shreyala/453-Locker-Project/print files/description.txt

A folder containing all the 3D printed parts for the locker.
