shreyala/453-Locker-Project/cad-drawings/description.txt

This folder contains all the CAD drawings our team used in the implementation of the project.
