shreyala/453-Locker-Project/stl/bottomhousing.stl

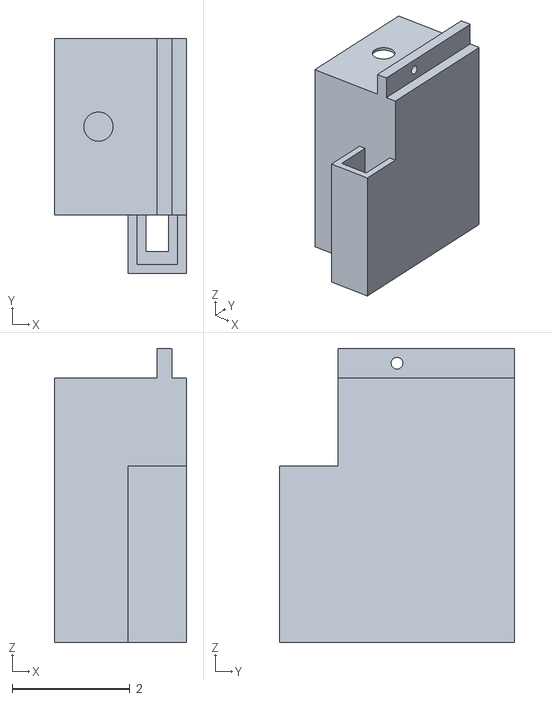
[picture p27: CAD file, 2021-05-12]
stl/bottomhousing.stl
2.25 x 4.00 x 5.00
