shreyala/453-Locker-Project/stl/tophousing.stl

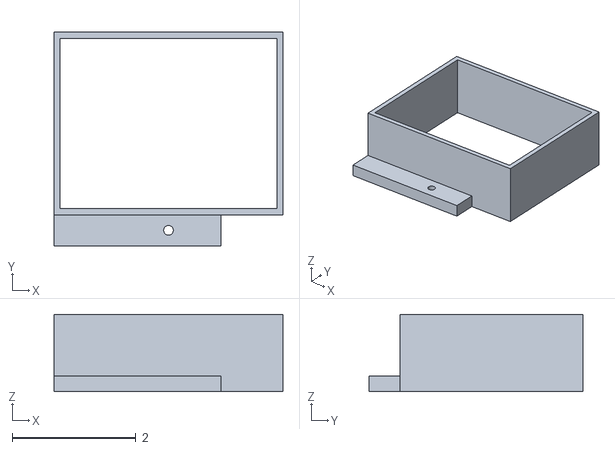
[picture p28: CAD file, 2021-05-12]
stl/tophousing.stl
3.70 x 3.45 x 1.25
