shreyala/453-Locker-Project/stl/insert3DHandle.stl

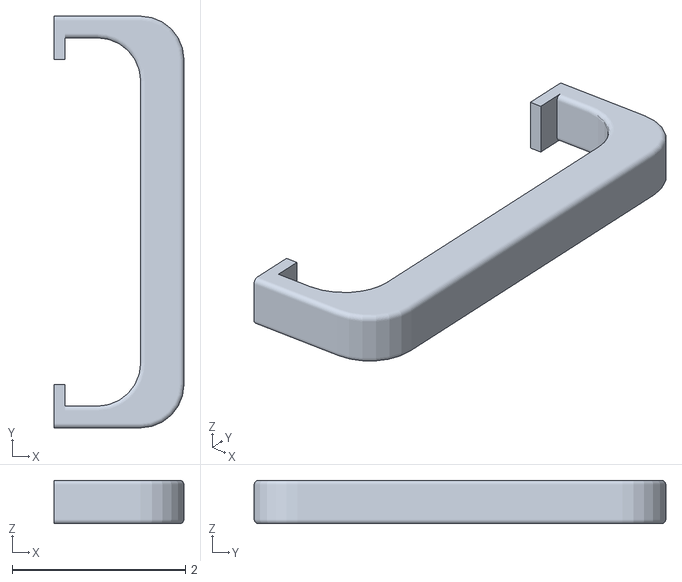
[picture p29: CAD file, 2021-05-12]
stl/insert3DHandle.stl
1.50 x 4.75 x 0.5
