shreyala/453-Locker-Project/stl/insert3DwithHandlecutout.stl

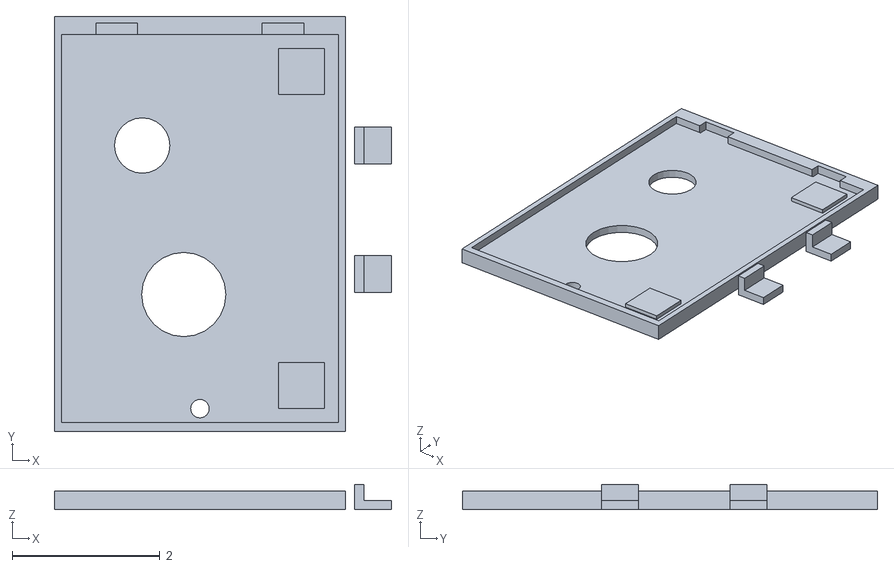
[picture p30: CAD file, 2021-05-12]
stl/insert3DwithHandlecutout.stl
4.56 x 5.62 x 0.344
