shreyala/453-Locker-Project/stl/L_mount.stl

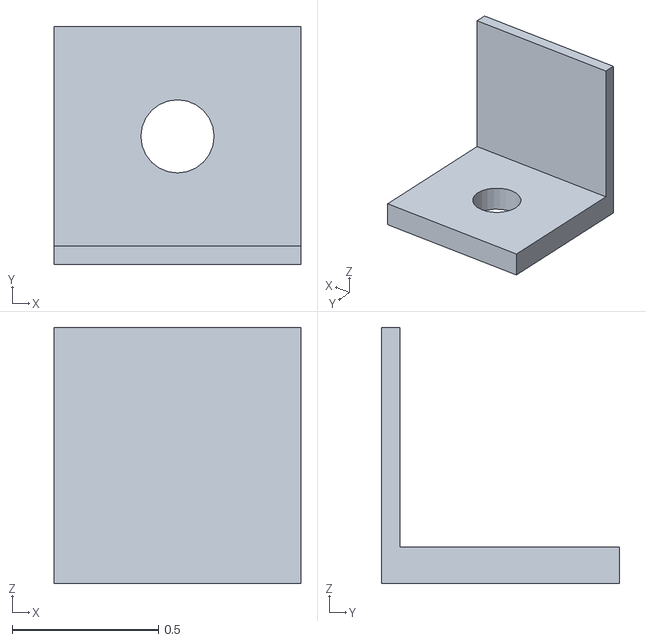
[picture p31: CAD file, 2021-05-12]
stl/L_mount.stl
0.844 x 0.812 x 0.875
