shreyala/453-Locker-Project/stl/bottomsleeve.stl

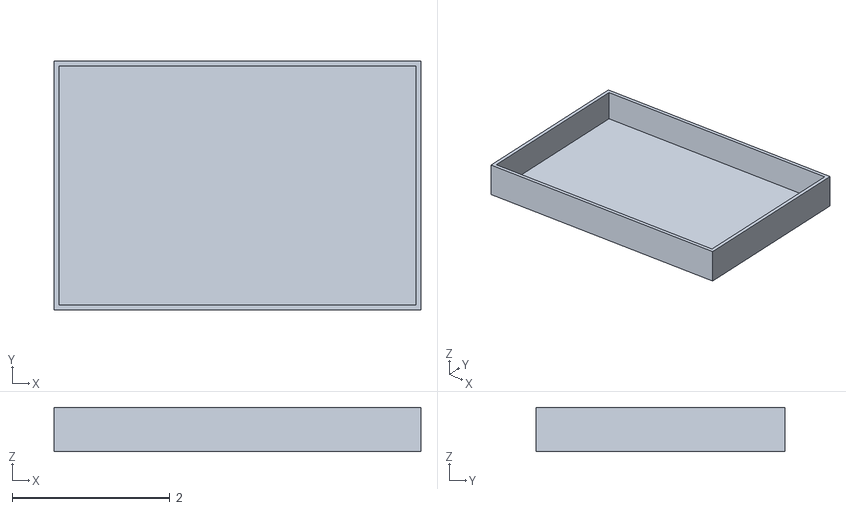
[picture p32: CAD file, 2021-05-12]
stl/bottomsleeve.stl
4.66 x 3.16 x 0.563
