shreyala/453-Locker-Project/stl/top_cover_cover.stl

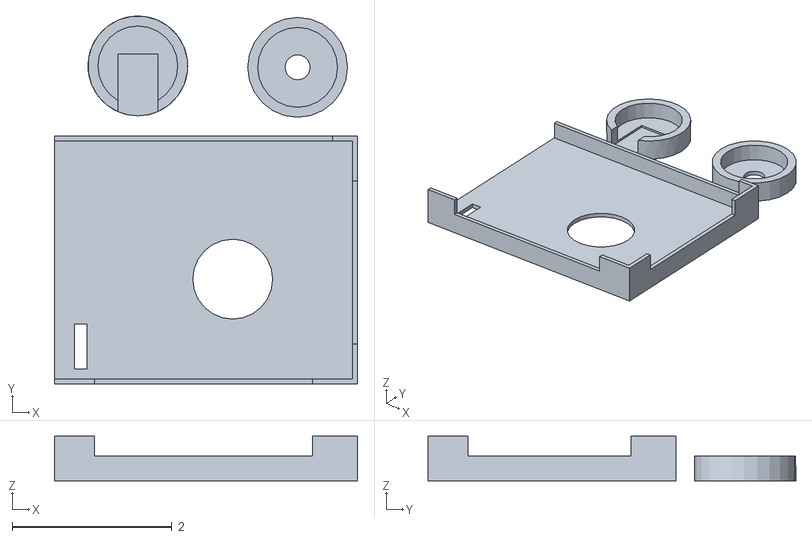
[picture p33: CAD file, 2021-05-12]
stl/top_cover_cover.stl
3.79 x 4.61 x 0.563
