shreyala/453-Locker-Project/(list of files, cad)

Other CAD files:
cad-drawings/bottomhousing.dwg
cad-drawings/bottomsleeve.dwg
cad-drawings/L_mount.dwg
cad-drawings/tophousing.dwg
cad-drawings/top_cover_cover.dwg
cad-drawings/insert3DwithHandlecutout.dwg
