shreyala/453-Locker-Project/locker.ino

/*
  
Automatic Locker Project

CSE 453

Spring 2021

Dr. Kris Schindler

Members:

Malik Saleh
Anthony Demartino
Timothy Newton
Benny Loo
Cameron Sturm
Shreya Lakhkar
Jacob Springborn

References:

Parallax Demo Code
https://www.parallax.com/package/rfid-read-write-module-arduino-code-example/
  
*/

// include the SoftwareSerial library so we can use it to talk to the RFID R/W Module
#include <SoftwareSerial.h>
#include <TimeInterrupt.h>


#define rxPin      11  // Serial input (connects to the RFID's SOUT pin)
#define txPin      10  // Serial output (connects to the RFID's SIN pin)
#define actuatorred  7
#define actuatorblack  8
#define turnoff 6

#define BUFSIZE    12  // Size of receive buffer (in bytes) for incoming data from the RFID R/W Module (this should be adjusted to be larger than the expected response)

// RFID R/W Module Commands
// Number of bytes returned in ()

#define RFID_Read         0x01    // Read data from specified address, valid locations 1 to 33 (5)
#define RFID_Write        0x02    // Write data to specified address, valid locations 3 to 31 (1)
#define RFID_Login        0x03    // Login to tag with password (1)
#define RFID_SetPass      0x04    // Change tag's password from old to new (1)
#define RFID_Protect      0x05    // Enable/disable password protection (1)
#define RFID_Reset        0x06    // Reset tag (1)
#define RFID_ReadLegacy   0x0F    // Read unique ID from EM4102 read-only tag (for backwards compatibility with Parallax RFID Card Reader #28140) (12)

// Memory map/address locations for EM4x50 tag
// Each address holds/returns a 32-bit (4 byte) value

#define ADDR_Password     0   // Password (not readable)
#define ADDR_Protect      1   // Protection Word
#define ADDR_Control      2   // Control Word

// ADDR 3-31 are User EEPROM area

#define ADDR_Serial       32    // Device Serial Number
#define ADDR_DeviceID     33    // Device Identification

// Status/error return codes

#define ERR_OK      0x01    // No errors
#define ERR_LIW     0x02    // Did not find a listen window
#define ERR_NAK     0x03    // Received a NAK, could be invalid command
#define ERR_NAK_OLDPW   0x04    // Received a NAK sending old password (RFID_SetPass), could be incorrect password
#define ERR_NAK_NEWPW   0x05    // Received a NAK sending new password (RFID_SetPass)
#define ERR_LIW_NEWPW   0x06    // Did not find a listen window after setting new password (RFID_SetPass)
#define ERR_PARITY    0x07    // Parity error when reading data

// For use with RFID_ReadLegacy command

#define LEGACY_StartByte  0x0A
#define LEGACY_StopByte   0x0D

int elapsedTime = 0;      // Integer that gets incremented in the timer handler every time a second passes
bool unlocked = false;    // Boolean to validate whether or not the state of the system is currently unlocked

// set up a new serial port
SoftwareSerial rfidSerial =  SoftwareSerial(rxPin, txPin);

void setup()  // Set up code called once on start-up
{
  // define pin modes
  
  pinMode(rxPin, INPUT);              // For RFID Module
  pinMode(txPin, OUTPUT);
  
  pinMode(9, OUTPUT);                 // For LED on Push Button
  
  pinMode(actuatorred, OUTPUT);       // For extending the Actuator
  pinMode(actuatorblack, OUTPUT);     // For retracting the Actuator
  
  pinMode(turnoff, OUTPUT);           // For the Kill Switch

  //Initialize the timer interrupt
  TimeInterrupt.addInterrupt(timeOut, 1000);
  TimeInterrupt.begin(NORMAL); 

  digitalWrite(9, HIGH);   // turn the LED on (HIGH is the voltage level)



 
  // setup Arduino Serial Monitor
  Serial.begin(115200);
  while (!Serial);   // wait until ready
  Serial.println("Listening...");
  
  // set the baud rate for the SoftwareSerial port
  rfidSerial.begin(9600);
  
  Serial.flush();   // wait for all bytes to be transmitted to the Serial Monitor
}



void loop()  // Main code, to run repeatedly
{

  
  char idx;
  uint8_t rfidData[BUFSIZE];  // Buffer for incoming data
  String taginputL="";
  char *validTags[] = {"1F00D790F8", "20007FA5BA", "0500023FDB", "0400C37327", "01009C3AA6"};
  


     
  Serial.print("Reading legacy tag's unique serial number...");  // Read unique ID from EM4102 read-only tag (used with the Parallax RFID Card Reader #28140)
  
  while(rfidReadLegacy(rfidData) != 0)
  

  
  taginputL = (char*)rfidData;
  Serial.println(taginputL);   // The rfidData string should now contain the tag's unique ID with a null termination, so display it on the Serial Monitor
  Serial.flush();
   
  if(taginputL == validTags[0] || taginputL == validTags[1] || taginputL == validTags[2] || taginputL == validTags[3] || taginputL == validTags[4])
      {
        
        Serial.print("Correct");

        unlocked = true;
        
        // lower it first in case it turned off extended
        digitalWrite(actuatorred, HIGH);
        digitalWrite(actuatorblack, LOW);

         // Blink the LED 3 Times while lowering to show correct tag
         
        digitalWrite(9, LOW);   // turn the LED on (HIGH is the voltage level)
        delay(400);
        digitalWrite(9, HIGH);   // turn the LED on (HIGH is the voltage level)
        delay(400);
        digitalWrite(9, LOW);   // turn the LED on (HIGH is the voltage level)
        delay(400);
        digitalWrite(9, HIGH);   // turn the LED on (HIGH is the voltage level)
        delay(400);
        digitalWrite(9, LOW);   // turn the LED on (HIGH is the voltage level)
        delay(400);
        digitalWrite(9, HIGH);   // turn the LED on (HIGH is the voltage level)
        
        //extending the actuator
        digitalWrite(actuatorred, LOW);
        digitalWrite(actuatorblack, HIGH); 
        delay(1600);

        // stop the actuator
        digitalWrite(actuatorred, LOW);
        digitalWrite(actuatorblack, LOW);
        delay(2000);
        
        //retracting the actuator
        digitalWrite(actuatorred, HIGH);
        digitalWrite(actuatorblack, LOW); 
        delay(3500);

        // stop the actuator
        digitalWrite(actuatorred, LOW);
        digitalWrite(actuatorblack, LOW);
        
        // Apply voltage to 'Off' pin on power switch breakout to power down system
        digitalWrite(turnoff, HIGH); 
        
      }
       
       else
      {

       Serial.print("Incorrect");

       // Turn LED off for about 2 seconds to show that the Incorrect Tag was scanned
       digitalWrite(9, LOW);   // turn the LED on (HIGH is the voltage level)
       delay(1500);
       digitalWrite(9, HIGH);   // turn the LED on (HIGH is the voltage level)

       
       }

     
    Serial.println();
    Serial.flush();

}

void timeOut()
{
  // Timer Interrupt Handler for counting elapsed time and shutting off when maximum time without activity is reached
  
  elapsedTime++;
  if(elapsedTime == 15 && unlocked != true) digitalWrite(turnoff, HIGH);

}

/*** SUPPORTING FUNCTIONS ***/

char rfidRead(uint8_t *data, uint8_t address)
{
  char offset;  // offset into buffer
  
  rfidFlush();  // empties any buffered incoming serial data
  
  rfidSerial.print("!RW");       // header
  rfidSerial.write(RFID_Read);   // command
  rfidSerial.write(address);     // address
    
  while (rfidSerial.available() != 5);  // wait until data is received from RFID module
  
  if (rfidSerial.read() == ERR_OK)  // if our status byte is OK
  {
    for (offset = 0; offset < 4; offset++)
      data[offset] = rfidSerial.read();  // get the remaining data
       
    return 0; // return good
  }
  
  return -1; // return error
}


char rfidWrite(uint8_t address, uint8_t *data)
{
  char offset;  // offset into buffer
  
  rfidFlush();  // empties any buffered incoming serial data
  
  rfidSerial.print("!RW");        // header
  rfidSerial.write(RFID_Write);   // command
  rfidSerial.write(address);      // address
  for (offset = 0; offset < 4; offset++)
    rfidSerial.write(data[offset]);     // data (4 bytes) 
  
  while (rfidSerial.available() == 0); // wait until data is received from RFID module

  if (rfidSerial.read() == ERR_OK) // if our status byte is OK
    return 0; // return good
  
  return -1; // return error
}


char rfidLogin(uint8_t *password)
{
  char offset;  // offset into buffer
  
  rfidFlush();  // empties any buffered incoming serial data
  
  rfidSerial.print("!RW");        // header
  rfidSerial.write(RFID_Login);   // command
  for (offset = 0; offset < 4; offset++)
    rfidSerial.write(password[offset]);     // password (4 bytes) 
  
  while (rfidSerial.available() == 0); // wait until data is received from RFID module

  if (rfidSerial.read() == ERR_OK) // if our status byte is OK
    return 0; // return good
  
  return -1; // return error
}


char rfidSetPass(uint8_t *currentpass, uint8_t *newpass)
{
  char offset;  // offset into buffer
  
  rfidFlush();  // empties any buffered incoming serial data
  
  rfidSerial.print("!RW");          // header
  rfidSerial.write(RFID_SetPass);   // command
  for (offset = 0; offset < 4; offset++)
    rfidSerial.write(currentpass[offset]);  // current password (4 bytes) 
  for (offset = 0; offset < 4; offset++)
    rfidSerial.write(newpass[offset]);      // new password (4 bytes) 
    
  while (rfidSerial.available() == 0); // wait until data is received from RFID module

  if (rfidSerial.read() == ERR_OK) // if our status byte is OK
    return 0; // return good
  
  return -1; // return error
}


char rfidProtect(boolean enable)
{
  rfidFlush();  // empties any buffered incoming serial data
  
  rfidSerial.print("!RW");          // header
  rfidSerial.write(RFID_Protect);   // command  
  if (enable == false)              // flag
    rfidSerial.write((byte)0);
  else
    rfidSerial.write((byte)1);
  
  while (rfidSerial.available() == 0); // wait until data is received from RFID module

  if (rfidSerial.read() == ERR_OK) // if our status byte is OK
    return 0; // return good
  
  return -1; // return error    
}


char rfidReset()
{
  rfidFlush();  // empties any buffered incoming serial data
  
  rfidSerial.print("!RW");        // header
  rfidSerial.write(RFID_Reset);   // command  
  
  while (rfidSerial.available() == 0); // wait until data is received from RFID module

  if (rfidSerial.read() == ERR_OK) // if our status byte is OK
    return 0; // return good
  
  return -1; // return error    
}


char rfidReadLegacy(uint8_t *data)
{
  char offset;  // offset into buffer
  
  rfidFlush();  // empties any buffered incoming serial data
  
  rfidSerial.print("!RW");             // header
  rfidSerial.write(RFID_ReadLegacy);   // command
    
  while (rfidSerial.available() != 12);  // wait until data is received from RFID module
  
  if (rfidSerial.read() == LEGACY_StartByte)  // if our start byte is OK
  {
    for (offset = 0; offset < 10; offset++)
      data[offset] = rfidSerial.read();  // get the remaining data
       
    data[offset] = 0;  // null terminate the string of bytes we just received   
    return 0; // return good
  }
  
  return -1; // return error
}


void rfidFlush()  // Empties any buffered incoming serial data
{
    while (rfidSerial.available() > 0)
      rfidSerial.read();
}


// from http://forum.arduino.cc/index.php?topic=38107#msg282343
void PrintHex(uint8_t *data, uint8_t length) // prints 8-bit data in hex
{
  char tmp[length*2+1];
  byte first ;
  int j=0;
  for (uint8_t i=0; i<length; i++) 
  {
    first = (data[i] >> 4) | 48;
    if (first > 57) tmp[j] = first + (byte)39;
    else tmp[j] = first ;
    j++;

    first = (data[i] & 0x0F) | 48;
    if (first > 57) tmp[j] = first + (byte)39; 
    else tmp[j] = first;
    j++;
  }
  tmp[length*2] = 0;
  Serial.print(tmp);
}

String SaveHex(uint8_t *data, uint8_t length) // prints 8-bit data in hex
{
  char tmp[length*2+1];
  byte first ;
  int j=0;
  for (uint8_t i=0; i<length; i++) 
  {
    first = (data[i] >> 4) | 48;
    if (first > 57) tmp[j] = first + (byte)39;
    else tmp[j] = first ;
    j++;

    first = (data[i] & 0x0F) | 48;
    if (first > 57) tmp[j] = first + (byte)39; 
    else tmp[j] = first;
    j++;
  }
  tmp[length*2] = 0;
  return tmp;
}
