shreyala/453-Locker-Project/(commit log)

2021-05-12 Final Arduino code for the locker
2021-05-12 CAD Drawings
    [L_mount.dwg, bottomhousing.dwg, bottomsleeve.dwg, insert3DwithHandlecutout.dwg, top_cover_cover.dwg, tophousing.dwg]
2021-05-12 Update and rename bottomhousing.dwg to description.txt
    [bottomhousing.dwg]
2021-05-12 Printed Files
